Your-Dear/warehouse_robot/README.md

# warehouse_robot
Design of a loading and unloading system for a warehouse robot using SolidWorks.
