Your-Dear/warehouse_robot/individual_assemblies/belt_pulley2/belt_pulley_system.SLDASM

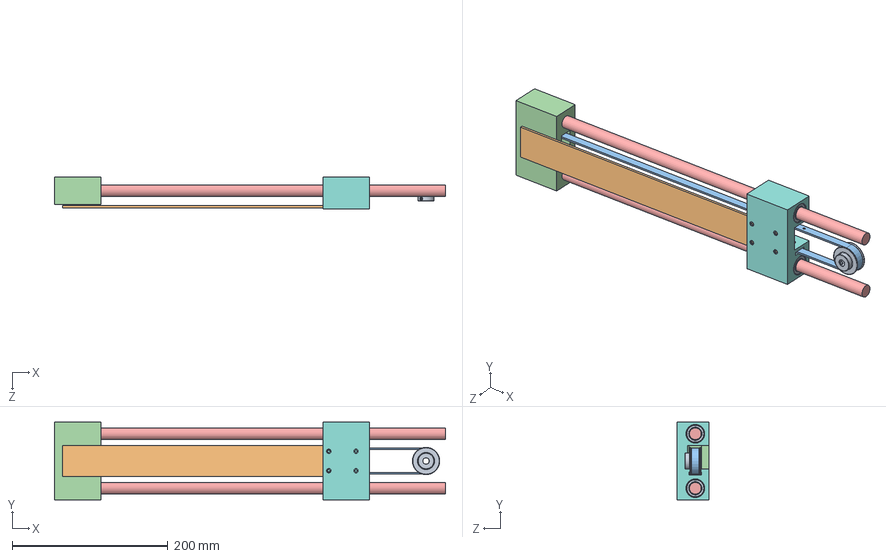
[picture p18: CAD file, 2025-07-16]
individual_assemblies/belt_pulley2/belt_pulley_system.SLDASM
502.5 x 100.0 x 41.0 mm
1277N717_Corrosion-Resistant Timing Belt Pulley
1355K1_Flat-Belt Idler Pulley
Belt1-8
end
axis x 2
socket head thin cap screw_din
hex nut style 2 gradeab_din
middle_slider
LM15UU x 2
thin_aluminum_rule
