Your-Dear/warehouse_robot/individual_assemblies/main_axis/z_axis_assembly.SLDASM

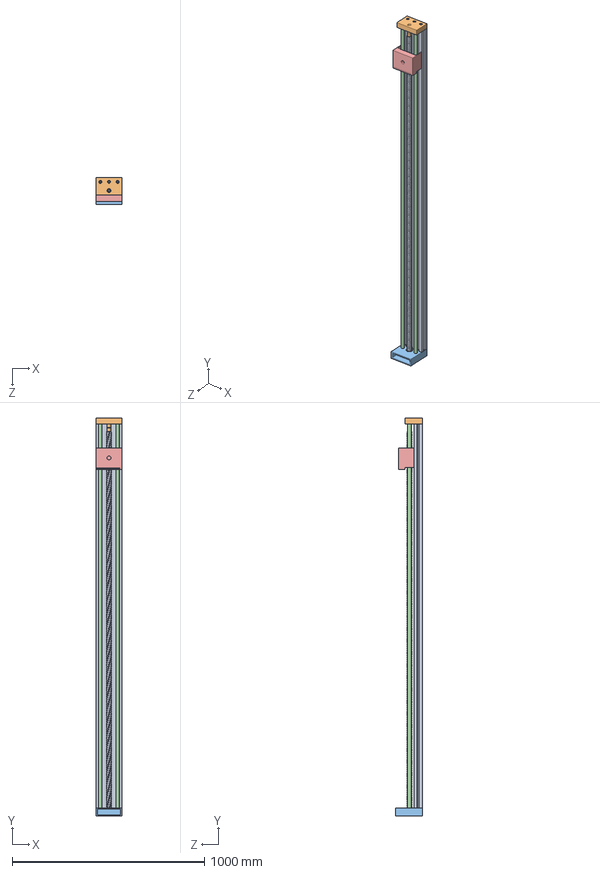
[picture p19: CAD file, 2025-07-16]
individual_assemblies/main_axis/z_axis_assembly.SLDASM
135.0 x 2072.0 x 140.0 mm
aluminum_profile
top
bottom
vertical_axis_d19mm x 2
slider_right
linear_bearing19mm x 2
screw_worm_drive
radial ball bearing_68_din
worm_drive
coupling
socket head cap screw_din x 3
washer5mm x 2
socket head cap screw 4762_din x 6
