Your-Dear/warehouse_robot/individual_assemblies/belt_pulley2/parts/end.SLDPRT

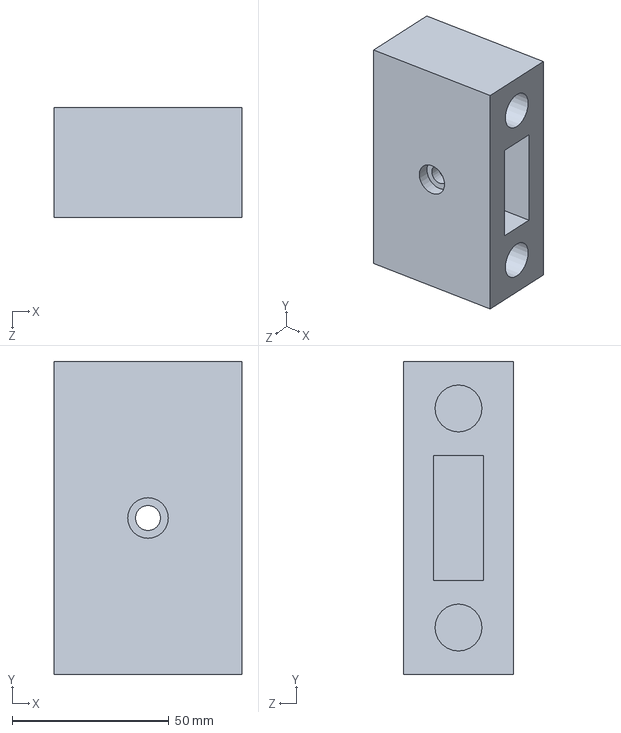
[picture p20: CAD file, 2025-07-16]
individual_assemblies/belt_pulley2/parts/end.SLDPRT
60.0 x 100.0 x 35.0 mm
