Your-Dear/warehouse_robot/individual_assemblies/belt_pulley2__mirrored/parts/Belt1-8.SLDPRT

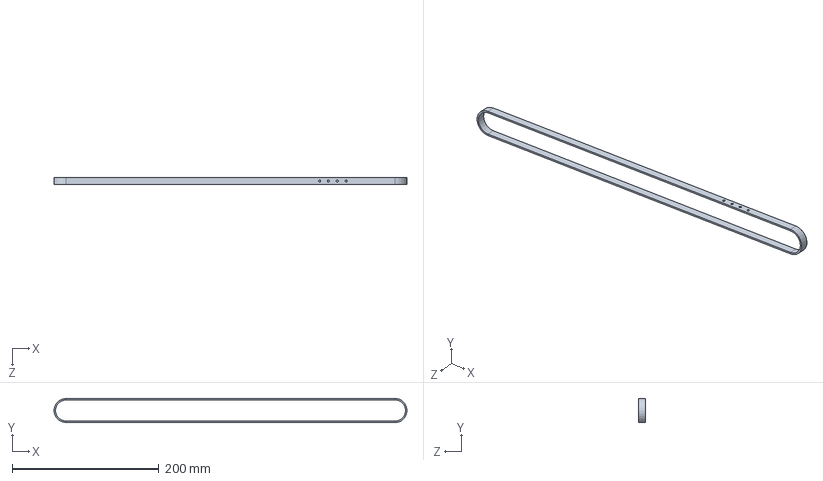
[picture p21: CAD file, 2025-07-16]
individual_assemblies/belt_pulley2__mirrored/parts/Belt1-8.SLDPRT
480.3 x 33.0 x 10.0 mm
