Your-Dear/warehouse_robot/individual_assemblies/main_axis/parts/bottom.SLDPRT

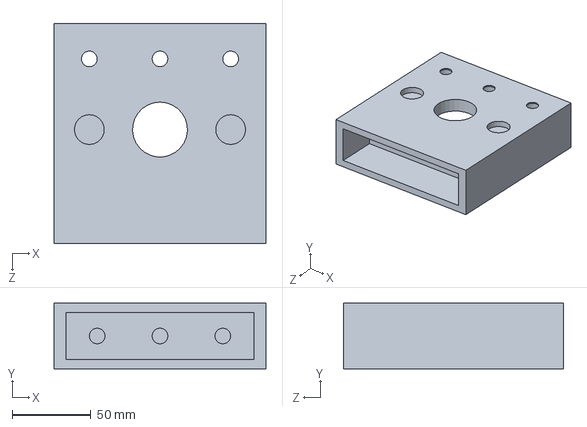
[picture p22: CAD file, 2025-07-16]
individual_assemblies/main_axis/parts/bottom.SLDPRT
135.0 x 42.0 x 140.0 mm
