Your-Dear/warehouse_robot/individual_assemblies/belt_pulley2__mirrored/parts/axis.SLDPRT

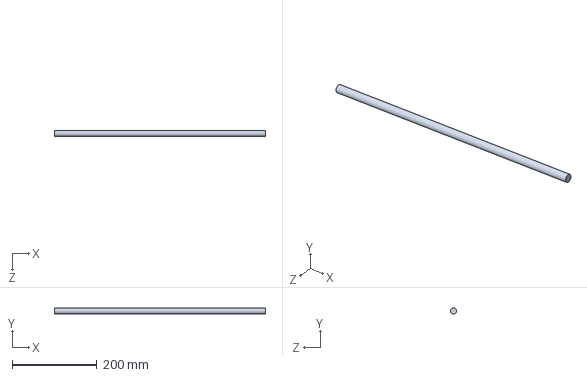
[picture p23: CAD file, 2025-07-16]
individual_assemblies/belt_pulley2__mirrored/parts/axis.SLDPRT
497.5 x 15.0 x 15.0 mm
