Your-Dear/warehouse_robot/individual_assemblies/main_axis/parts/srew_M1.4 x 20 - head20.SLDPRT

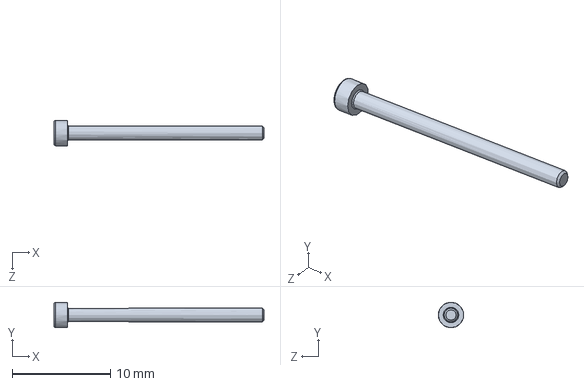
[picture p24: CAD file, 2025-07-16]
individual_assemblies/main_axis/parts/srew_M1.4 x 20 - head20.SLDPRT
21.4 x 2.58 x 2.60 mm
