Your-Dear/warehouse_robot/individual_assemblies/belt_pulley2/parts/1355K1_Flat-Belt Idler Pulley.SLDPRT

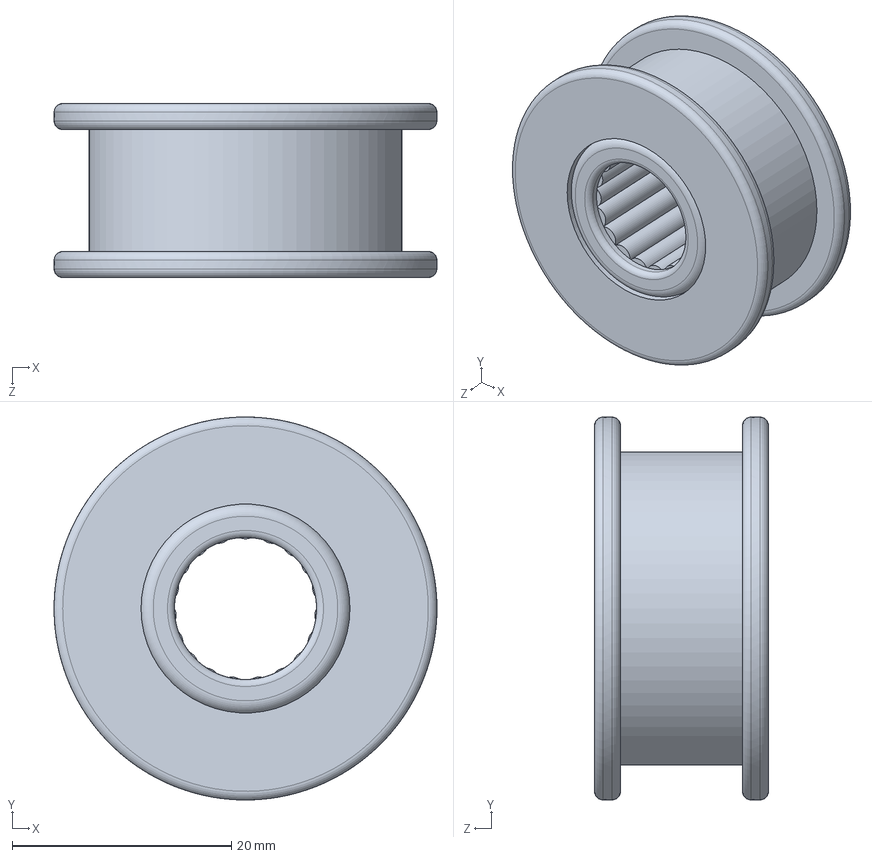
[picture p25: CAD file, 2025-07-16]
individual_assemblies/belt_pulley2/parts/1355K1_Flat-Belt Idler Pulley.SLDPRT
34.9 x 34.9 x 15.9 mm
