Your-Dear/warehouse_robot/individual_assemblies/belt_pulley2__mirrored/parts/LM15UU.SLDPRT

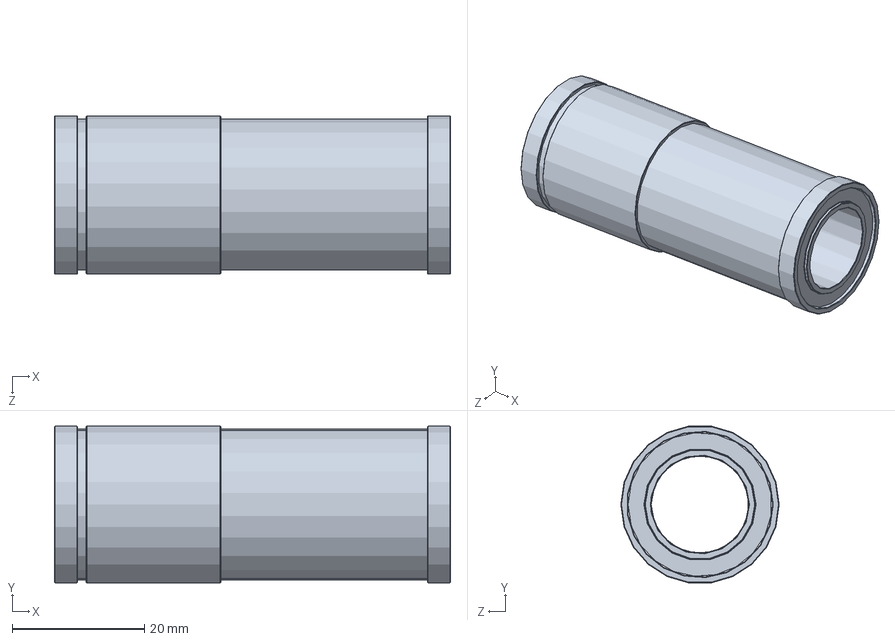
[picture p26: CAD file, 2025-07-16]
individual_assemblies/belt_pulley2__mirrored/parts/LM15UU.SLDPRT
60.0 x 23.8 x 24.0 mm
