Your-Dear/warehouse_robot/individual_assemblies/main_axis/parts/EN ISO 4762 M1.4 x 10 - 10N.SLDPRT

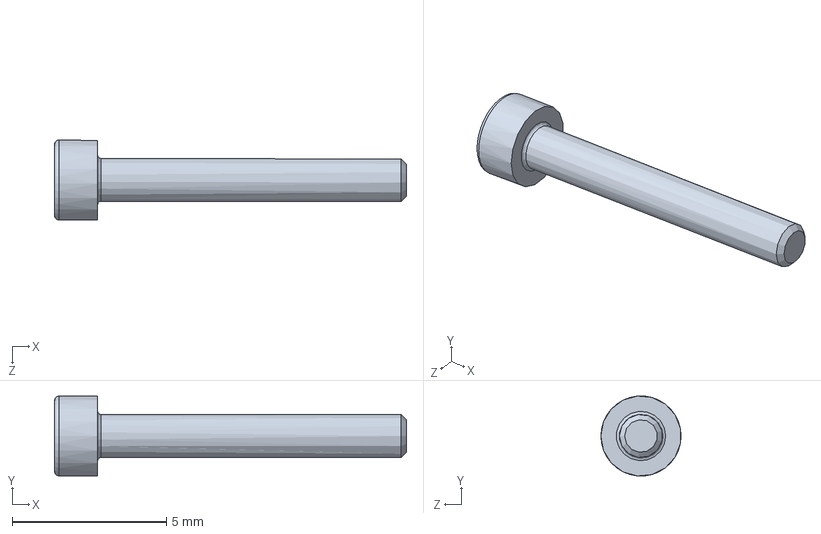
[picture p27: CAD file, 2025-07-16]
individual_assemblies/main_axis/parts/EN ISO 4762 M1.4 x 10 - 10N.SLDPRT
11.4 x 2.59 x 2.60 mm
