Your-Dear/warehouse_robot/individual_assemblies/Mirrorz_axis_assembly/parts/Mirrorslider_right.SLDPRT

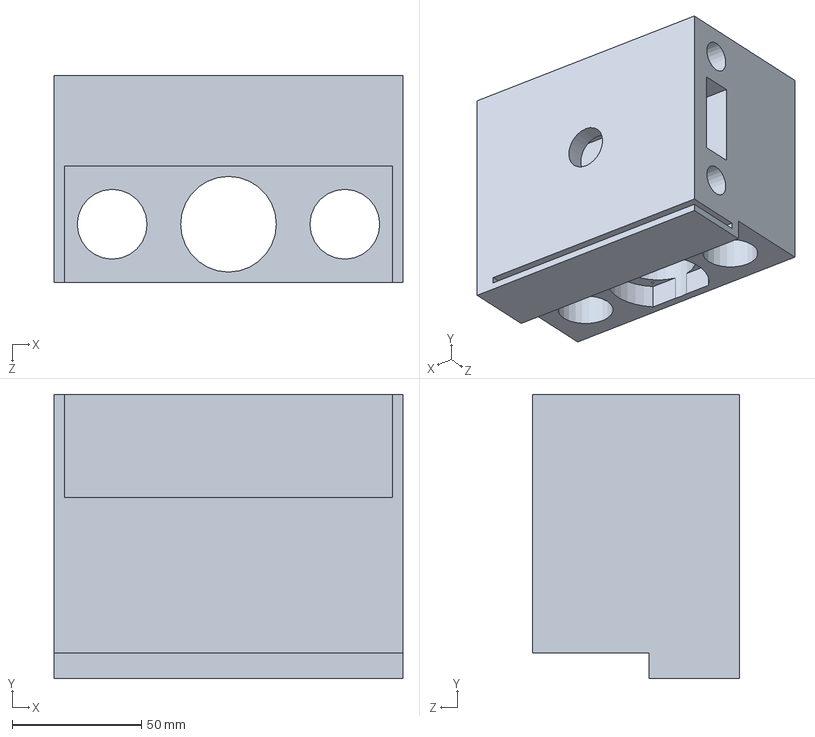
[picture p28: CAD file, 2025-07-16]
individual_assemblies/Mirrorz_axis_assembly/parts/Mirrorslider_right.SLDPRT
135.0 x 110.0 x 80.0 mm
