Your-Dear/warehouse_robot/individual_assemblies/main_axis/parts/linear_bearing19mm.SLDPRT

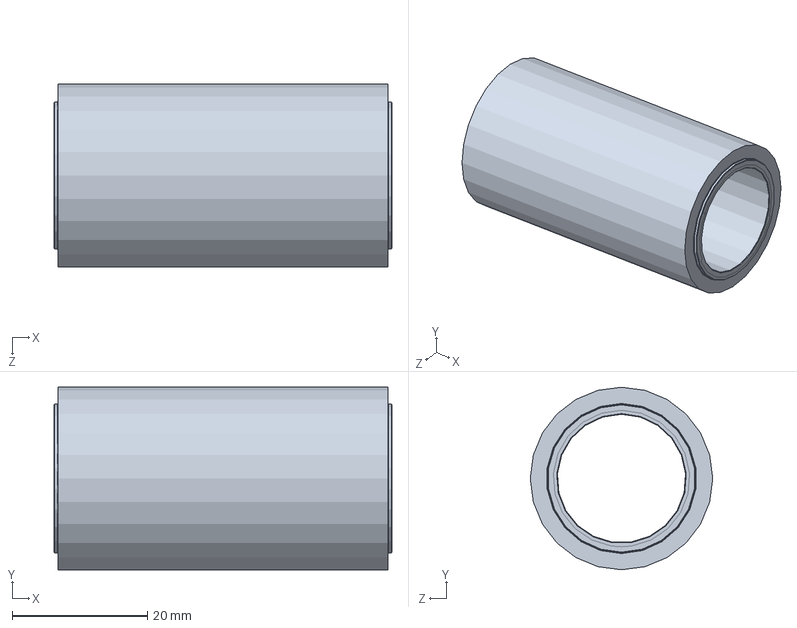
[picture p29: CAD file, 2025-07-16]
individual_assemblies/main_axis/parts/linear_bearing19mm.SLDPRT
50.0 x 27.0 x 27.0 mm
