Your-Dear/warehouse_robot/individual_assemblies/belt_pulley2__mirrored/parts/thin_aluminum_rule.SLDPRT

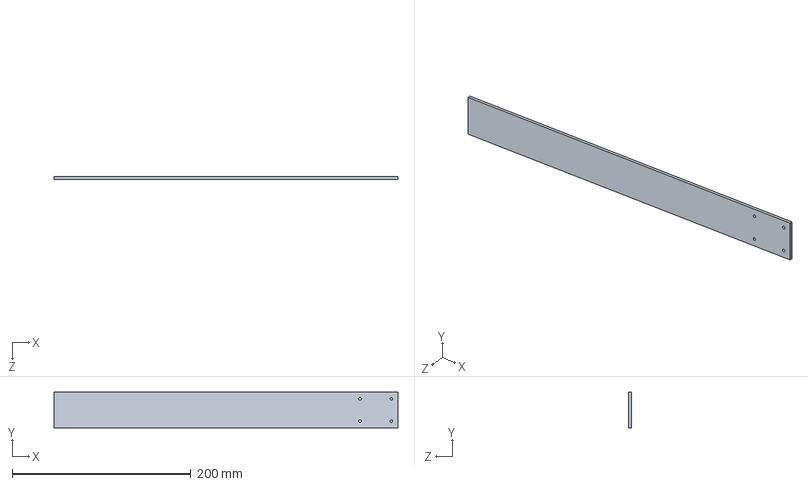
[picture p30: CAD file, 2025-07-16]
individual_assemblies/belt_pulley2__mirrored/parts/thin_aluminum_rule.SLDPRT
385.0 x 40.0 x 3.00 mm
