Your-Dear/warehouse_robot/individual_assemblies/main_axis/parts/coupling.SLDPRT

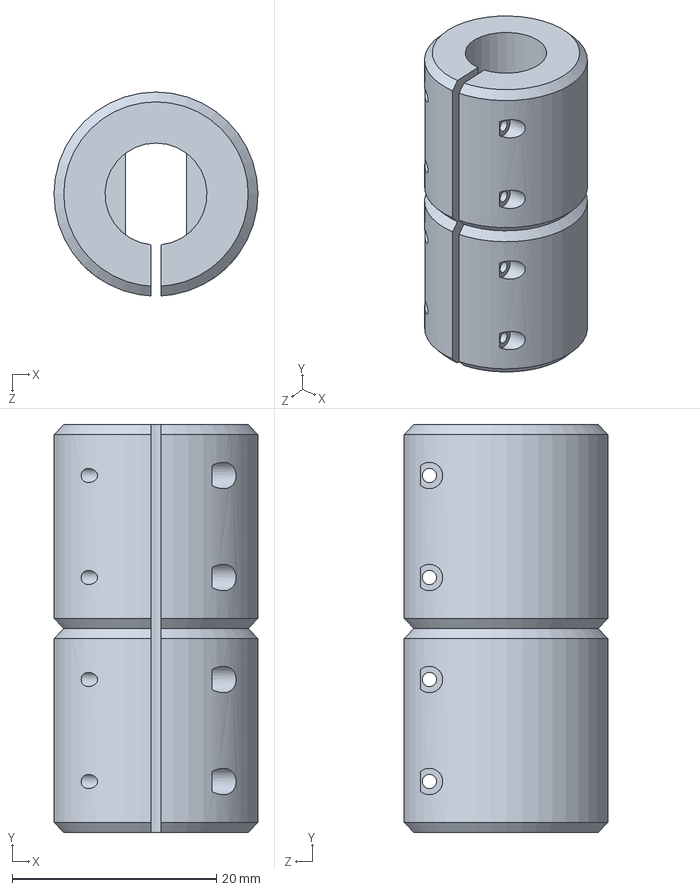
[picture p31: CAD file, 2025-07-16]
individual_assemblies/main_axis/parts/coupling.SLDPRT
20.0 x 40.0 x 20.0 mm
