Your-Dear/warehouse_robot/individual_assemblies/main_axis/parts/small_alprofile.SLDPRT

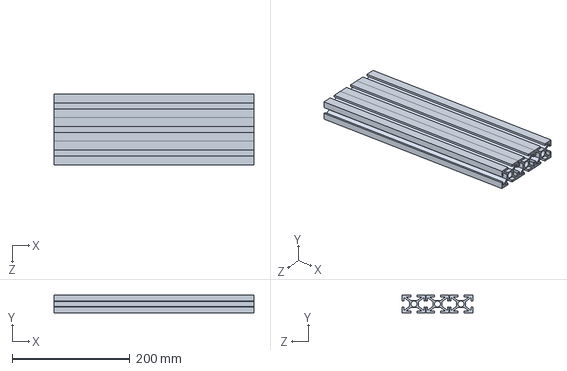
[picture p32: CAD file, 2025-07-16]
individual_assemblies/main_axis/parts/small_alprofile.SLDPRT
340.0 x 30.1 x 120.1 mm
