Your-Dear/warehouse_robot/individual_assemblies/main_axis/parts/worm_drive.SLDPRT

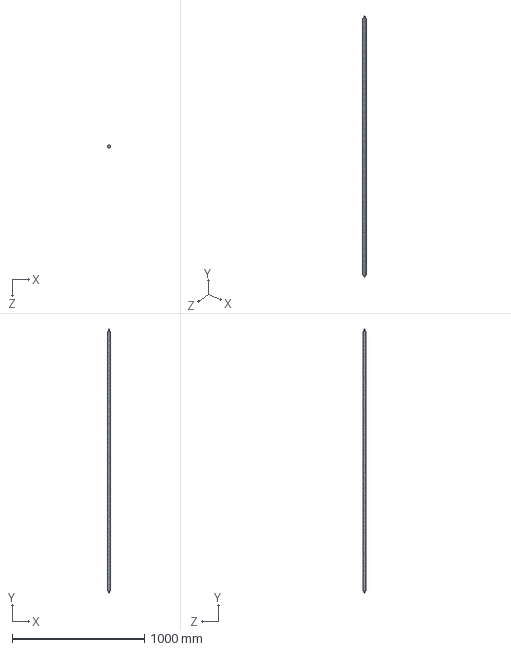
[picture p33: CAD file, 2025-07-16]
individual_assemblies/main_axis/parts/worm_drive.SLDPRT
25.0 x 1995.0 x 25.0 mm
