Your-Dear/warehouse_robot/individual_assemblies/main_axis/parts/vertical_axis_d19mm.SLDPRT

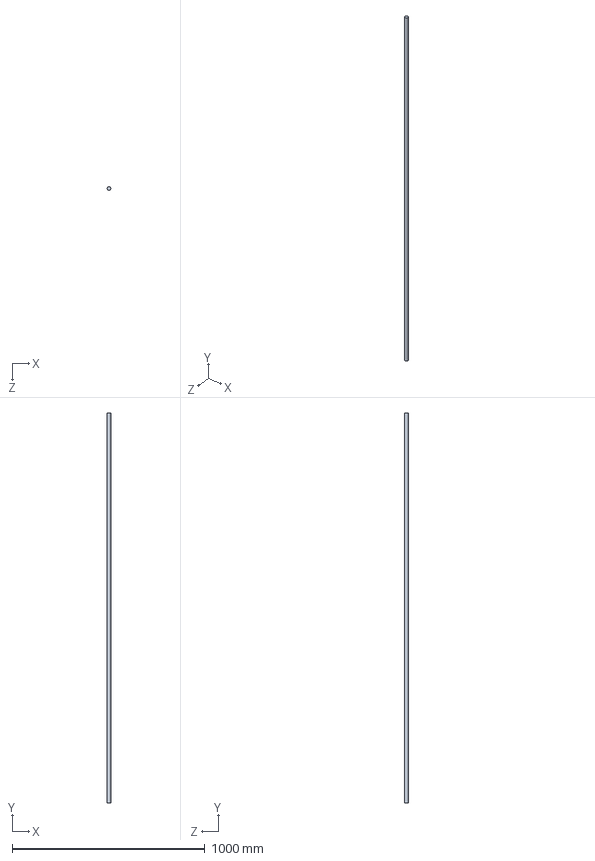
[picture p34: CAD file, 2025-07-16]
individual_assemblies/main_axis/parts/vertical_axis_d19mm.SLDPRT
19.0 x 2025.0 x 19.0 mm
