Your-Dear/warehouse_robot/individual_assemblies/belt_pulley2/parts/middle_slider.SLDPRT

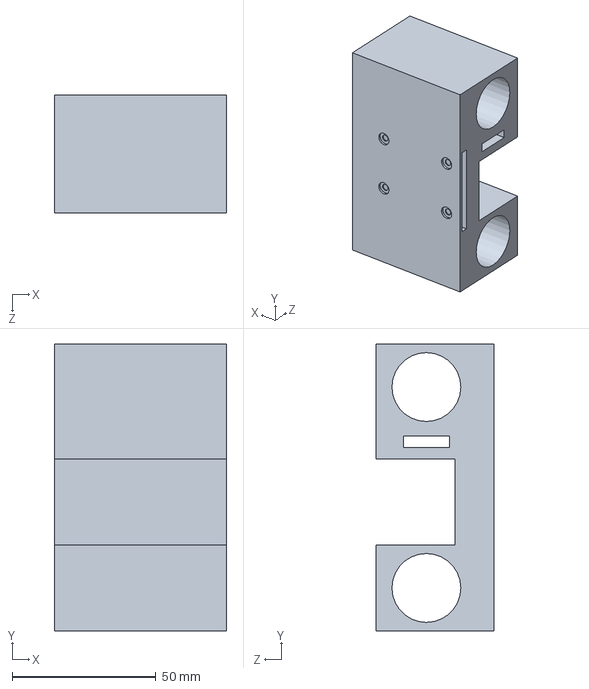
[picture p35: CAD file, 2025-07-16]
individual_assemblies/belt_pulley2/parts/middle_slider.SLDPRT
60.0 x 100.0 x 41.0 mm
