Your-Dear/warehouse_robot/individual_assemblies/main_axis/parts/aluminum_profile.SLDPRT

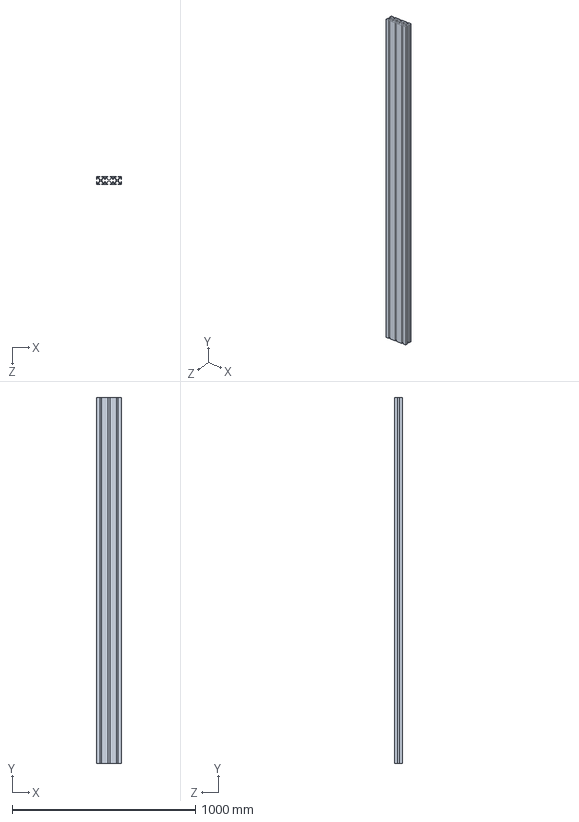
[picture p36: CAD file, 2025-07-16]
individual_assemblies/main_axis/parts/aluminum_profile.SLDPRT
135.0 x 2000.0 x 45.0 mm
