Your-Dear/warehouse_robot/individual_assemblies/main_axis/parts/bed.SLDPRT

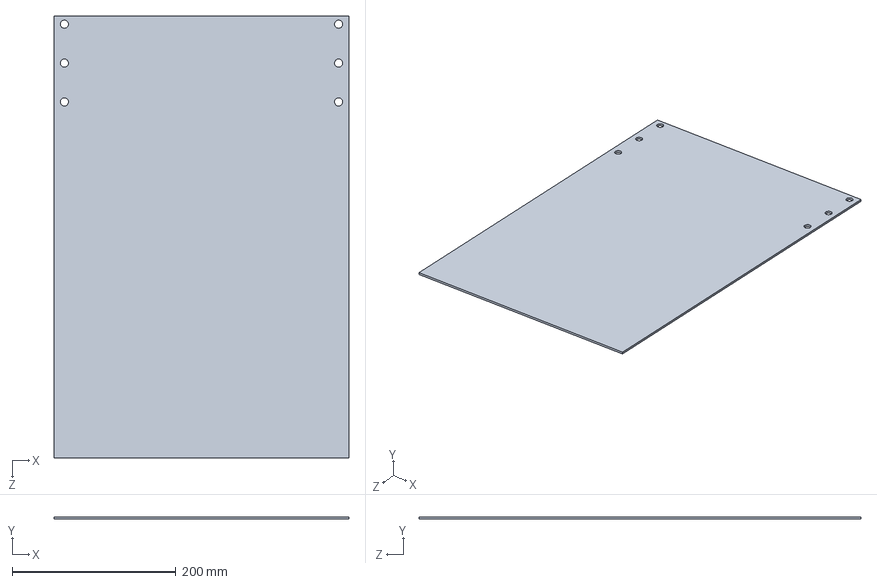
[picture p37: CAD file, 2025-07-16]
individual_assemblies/main_axis/parts/bed.SLDPRT
360.0 x 3.00 x 540.0 mm
