Your-Dear/warehouse_robot/individual_assemblies/Mirrorz_axis_assembly/parts/Mirrorbottom.SLDPRT

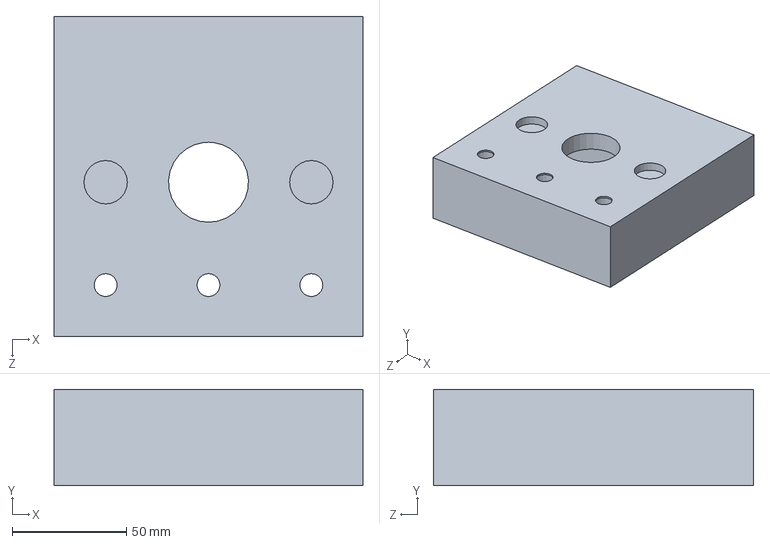
[picture p38: CAD file, 2025-07-16]
individual_assemblies/Mirrorz_axis_assembly/parts/Mirrorbottom.SLDPRT
135.0 x 42.0 x 140.0 mm
