Your-Dear/warehouse_robot/individual_assemblies/Mirrorz_axis_assembly/parts/Mirrortop.SLDPRT

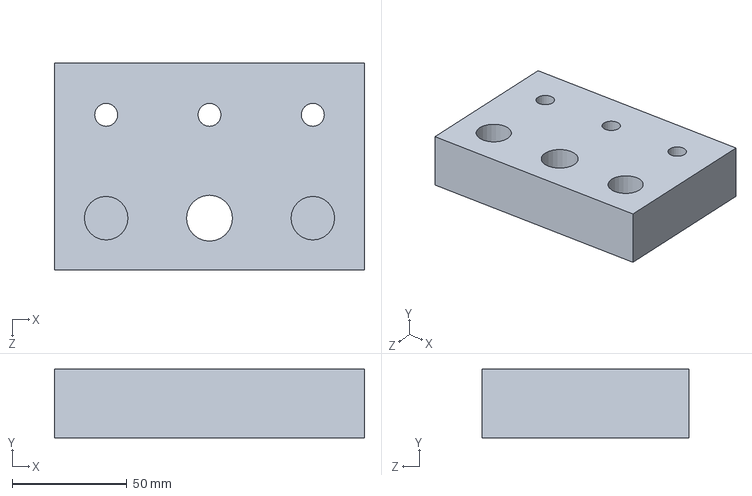
[picture p39: CAD file, 2025-07-16]
individual_assemblies/Mirrorz_axis_assembly/parts/Mirrortop.SLDPRT
135.0 x 30.0 x 90.0 mm
