Your-Dear/warehouse_robot/(list of files, cad)

Other CAD files:
individual_assemblies/belt_pulley2__mirrored/belt_pulley_system2.SLDASM
individual_assemblies/Mirrorz_axis_assembly/Mirrorz_axis_assembly.SLDASM
individual_assemblies/Mirrorz_axis_assembly/parts/MirrorLM15UU.SLDPRT
individual_assemblies/Mirrorz_axis_assembly/parts/Mirrorworm_drive.SLDPRT
individual_assemblies/Mirrorz_axis_assembly/parts/Mirror1277N717_Corrosion-Resistant Timing Belt Pulley.SLDPRT
individual_assemblies/Mirrorz_axis_assembly/parts/Mirrormiddle_slider.SLDPRT
individual_assemblies/Mirrorz_axis_assembly/parts/Mirrorvertical_axis_d19mm.SLDPRT
individual_assemblies/belt_pulley2/parts/Belt1-8.SLDPRT
individual_assemblies/Mirrorz_axis_assembly/parts/Mirror1355K1_Flat-Belt Idler Pulley.SLDPRT
individual_assemblies/Mirrorz_axis_assembly/parts/Mirrorcoupling.SLDPRT
individual_assemblies/Mirrorz_axis_assembly/parts/Mirrorthin_aluminum_rule.SLDPRT
individual_assemblies/Mirrorz_axis_assembly/parts/Mirroraxis.SLDPRT
individual_assemblies/Mirrorz_axis_assembly/parts/MirrorBelt1-8.SLDPRT
individual_assemblies/main_axis/parts/slider_right.SLDPRT
individual_assemblies/Mirrorz_axis_assembly/parts/Mirrorend.SLDPRT
individual_assemblies/Mirrorz_axis_assembly/parts/Mirroraluminum_profile.SLDPRT
individual_assemblies/Mirrorz_axis_assembly/parts/Mirrorlinear_bearing19mm.SLDPRT
individual_assemblies/main_axis/parts/top.SLDPRT
individual_assemblies/Mirrorz_axis_assembly/parts/DIN 7991 - M10 x 12 --- 12N.SLDPRT
individual_assemblies/Mirrorz_axis_assembly/parts/Mirrorscrew_worm_drive.SLDPRT
individual_assemblies/Mirrorz_axis_assembly/parts/Mirrorwasher5mm.SLDPRT
individual_assemblies/belt_pulley2/parts/1277N717_Corrosion-Resistant Timing Belt Pulley.SLDPRT
individual_assemblies/belt_pulley2/parts/DIN 7984 - M3 x 12 --- 10.5N.SLDPRT
individual_assemblies/belt_pulley2/parts/DIN 7984 - M8 x 30 --- 26.25N.SLDPRT
individual_assemblies/belt_pulley2/parts/DIN 7991 - M3 x 8 --- 4.8N.SLDPRT
individual_assemblies/belt_pulley2/parts/Hexagon Nut ISO 4033 - M8 - W - N.SLDPRT
individual_assemblies/belt_pulley2__mirrored/parts/1277N717_Corrosion-Resistant Timing Belt Pulley.SLDPRT
individual_assemblies/belt_pulley2__mirrored/parts/DIN 7984 - M3 x 12 --- 10.5N.SLDPRT
individual_assemblies/belt_pulley2__mirrored/parts/DIN 7984 - M8 x 30 --- 26.25N.SLDPRT
individual_assemblies/belt_pulley2__mirrored/parts/DIN 7991 - M3 x 8 --- 4.8N.SLDPRT
individual_assemblies/belt_pulley2__mirrored/parts/Hexagon Nut ISO 4033 - M8 - W - N.SLDPRT
individual_assemblies/main_axis/parts/DIN 625 - 6300 - 6,SI,NC,6_68.SLDPRT
individual_assemblies/main_axis/parts/DIN 7991 - M10 x 12 --- 12N.SLDPRT
individual_assemblies/main_axis/parts/DIN 912 M10 x 25 --- 25N.SLDPRT
individual_assemblies/main_axis/parts/screw_din10_dou16_lt35_lspi25.SLDPRT
individual_assemblies/main_axis/parts/screw_worm_drive.SLDPRT
individual_assemblies/main_axis/parts/screwhex_M1.4 x 4mm - 4N.SLDPRT
individual_assemblies/main_axis/parts/washer5mm.SLDPRT
